kanatronics/XsensVoltageTranslator/README.md

# XsensVoltageTranslator
Xsens Voltage Level translator
Assembly files for Voltage level translator.
Kamil Kanas
