kanatronics/XsensVoltageTranslator/capture-2023-05-11T11_30_45.297Z.png

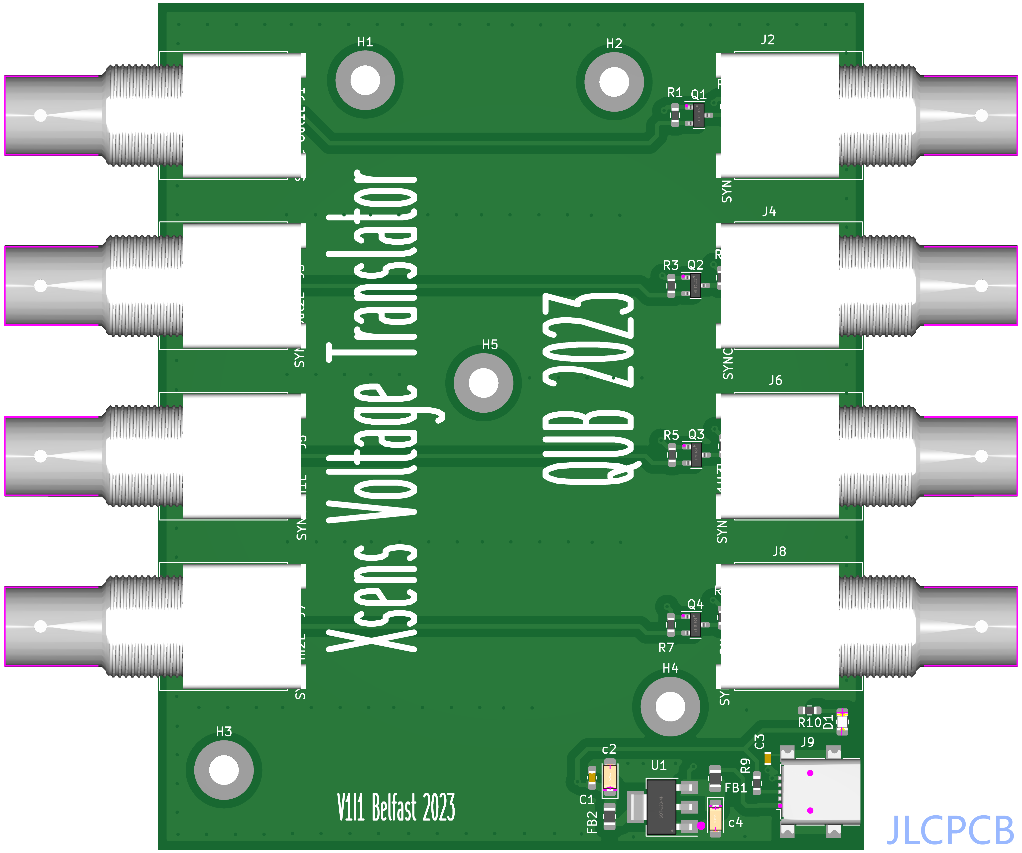
capture-2023-05-11T11_30_45.297Z.png
