kanatronics/XsensVoltageTranslator/Xsensbottom.stl

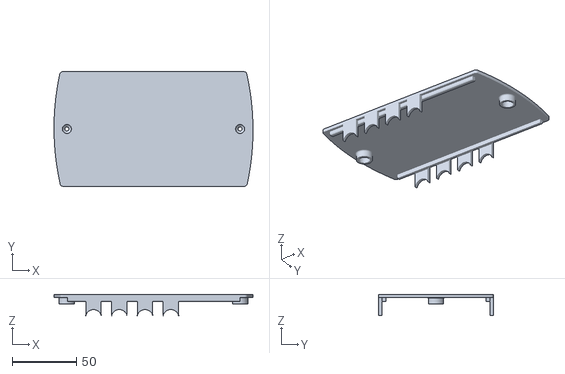
[picture p8: CAD file, 2023-08-28]
Xsensbottom.stl
154.5 x 89.0 x 16.5
