kanatronics/XsensVoltageTranslator/XsensTop.stl

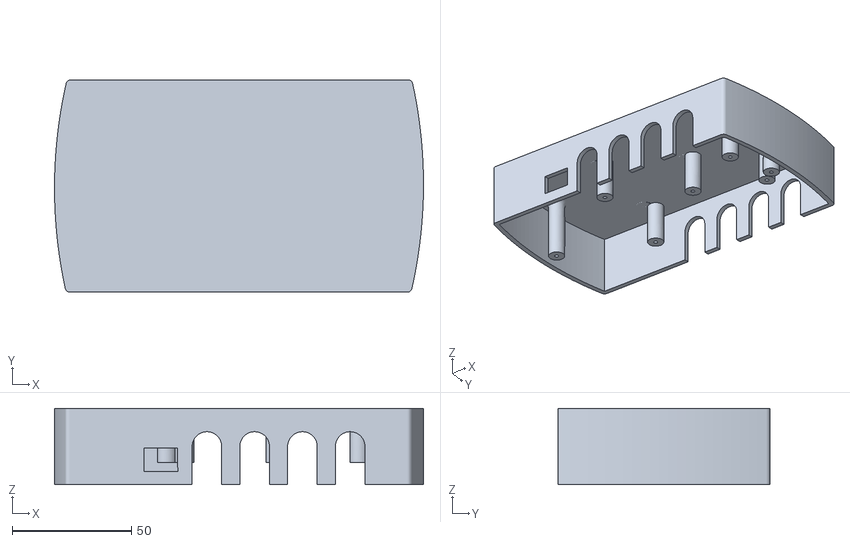
[picture p9: CAD file, 2023-08-28]
XsensTop.stl
154.5 x 89.0 x 32.0
